Ljzd-PRO/ice_panel_sniffer/docs/images/github-social-preview.png

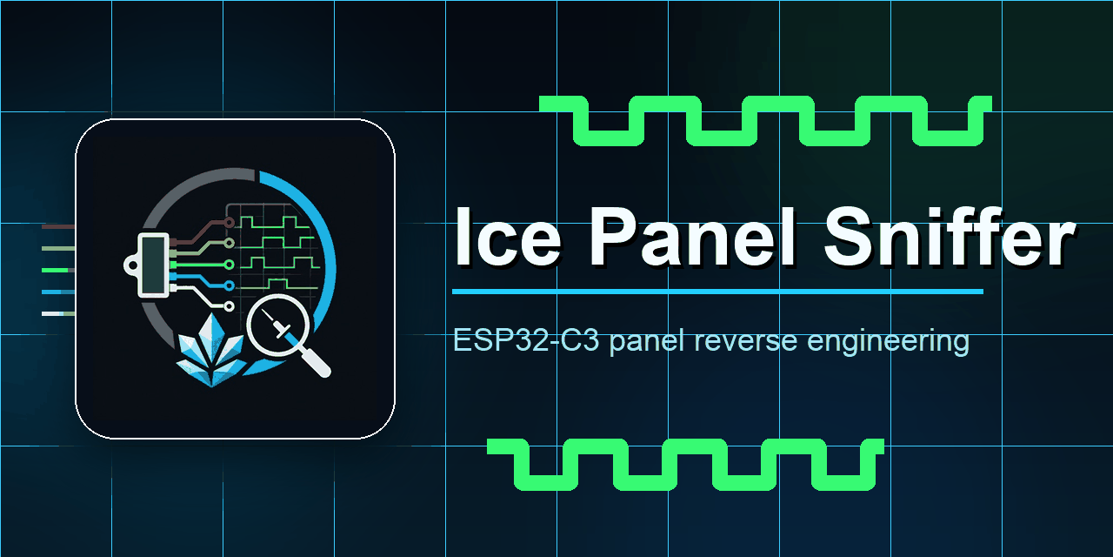
docs/images/github-social-preview.png
